NatashaBlong/Universal-Flex-Fuel-Translator/Flex Fuel Translator Schematic (Arduino Nano).png

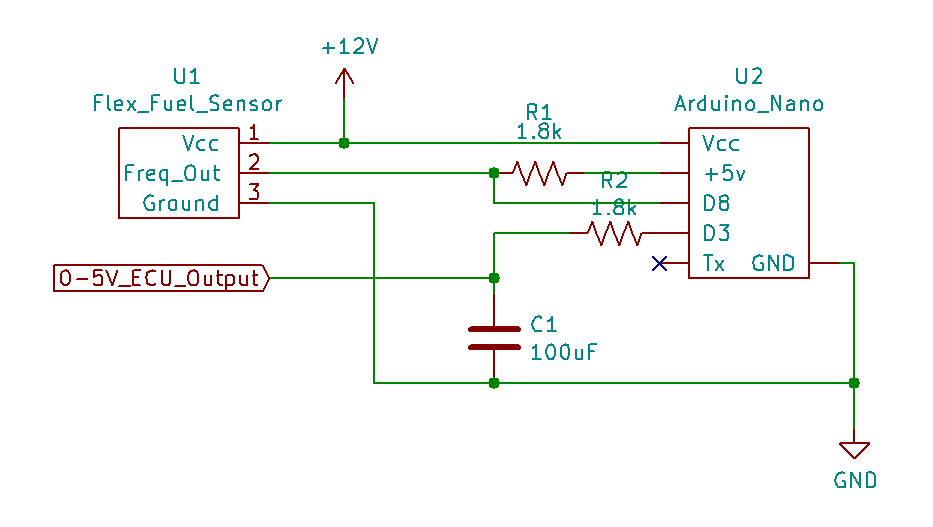
Flex Fuel Translator Schematic (Arduino Nano).png
